GROUNDUP-GmbH/vibrocore/docs/design/ARCHITECTURE.md

# System Architecture

## Overview

The Vibrocore V1 consists of five major subsystems. Vibration is generated by
two industrial OLI motors (not custom eccentric shafts). Control runs on a
ruggedized WAGO PFC200 XTR with Modbus RTU to both the VFD and hub driver.

```
┌──────────────────────────────────────────────────────────────────────┐
│                          VIBROCORE V1                                │
├──────────────────────────────────────────────────────────────────────┤
│                                                                      │
│  ┌──────────────────┐  ┌──────────────┐  ┌────────────────────────┐ │
│  │  1. SONIC HEAD   │  │  2. HUB      │  │  3. CONTROL SYSTEM     │ │
│  │                  │  │     SYSTEM   │  │                        │ │
│  │  2× OLI MVE      │  │  Linear      │  │  WAGO PFC200 XTR       │ │
│  │  400/6-HF        │  │  push/pull   │  │  + Siemens V20 VFD     │ │
│  │  @100 Hz, 8 kN   │  │  via chain   │  │  + Nanotec C5-E driver │ │
│  └──────────────────┘  └──────────────┘  └────────────────────────┘ │
│                                                                      │
│  ┌──────────────────────────────────────────────────────────────┐   │
│  │                  4. POWER SYSTEM                              │   │
│  │  Instagrid ONE max (230V AC, 3.6 kW) → VFD + 48V PSU        │   │
│  └──────────────────────────────────────────────────────────────┘   │
│                                                                      │
│  ┌──────────────────────────────────────────────────────────────┐   │
│  │                  5. FRAME & MOBILITY                          │   │
│  │  mk 2004 Al-profile mast · steel base · UTV mount · tilt     │   │
│  └──────────────────────────────────────────────────────────────┘   │
│                                                                      │
└──────────────────────────────────────────────────────────────────────┘
```

---

## Subsystem Interactions

```
       ┌─────────────────────────────┐
       │  Tablet / HMI (WLAN)        │  viDoc RTK AR navigation
       │  + viDoc RTK Light          │  GPS sample point targeting
       └──────────────┬──────────────┘
                      │ WLAN (WAGO REST API / MQTT)
       ┌──────────────▼──────────────────────────────┐
       │           WAGO PFC200 XTR                   │
       │      (CODESYS V3.5 / IEC 61131-3)           │
       │                                             │
       │  PRG_Main → FB_Safety                       │
       │           → FB_SonicHead                    │
       │           → FB_HubControl                   │
       │           → FB_DataLogger                   │
       └──────┬──────────────────┬───────────────────┘
              │ RS-485             │ RS-485
              │ Modbus RTU         │ Modbus RTU
              │ Slave addr 1       │ Slave addr 2
       ┌──────▼──────┐     ┌──────▼──────┐
       │ Siemens V20 │     │ Nanotec C5-E│
       │  VFD 1.5kW  │     │ Stepper drv │
       │  OFF3 stop  │     │  CiA 402    │
       └──────┬──────┘     └──────┬──────┘
              │ 3×AC               │ Phase
              ▼                   ▼
       ┌─────────────┐     ┌─────────────────────┐
       │ 2× OLI MVE  │     │ NEMA 42 stepper      │
       │ 400/6-HF    │     │ + Neugart PLPE120-040│
       │ counter-rot.│     │ + 10B-2 chain        │
       │ 6000 RPM    │     │ + carriage slider    │
       │ 8 kN total  │     └──────────┬──────────┘
       └──────┬──────┘                │
              │ vibration             │ linear push/pull
       ┌──────▼──────┐                │
       │ Vibrating   │                │
       │ plate       ◄────────────────┘
       │ (S355J2)    │   carriage holds sonic head
       └──────┬──────┘
              │ rubber isolators (4× M12, 70 Shore A)
       ┌──────▼──────┐
       │ Center      │
       │ column      │
       │ (42CrMo4)   │
       └──────┬──────┘
              │ threaded adapter
       ┌──────▼──────────────┐
       │ DT325 Core Barrel   │
       │ 3.25″ × 48″ rod     │
       │ + cutting shoe      │
       └─────────────────────┘
```

---

## Critical Interlock: Sonic → Hub

The most important safety/quality interlock in the system:

```
DRILLING state:
  Hub moves DOWN  ←→  Sonic RUNNING
        │
        ▼ (target depth OR stone OR lower limit)
        │
STOP_SONIC state:
  Hub BRAKE engaged
  Sonic fast-stop (OFF3) requested
  ↓
  WAIT: xSonicConfirmedStopped = TRUE
  (OLI motors confirmed at standstill for 200ms)
        │
        ▼
RETRACT state:
  Hub moves UP  ←  Sonic CONFIRMED stopped
```

**Rule:** The hub carriage CANNOT transition to the RETRACT state without
`FB_SonicHead.xConfirmedStopped = TRUE`. This is structural in the state
machine — there is no path from DRILLING directly to RETRACT.

Reason: OLI motors at 6000 RPM shaking the soil core during extraction would
cause the sample to fall out, destroying the density measurement.

---

## Data / Trust Layer

```
Sampling cycle complete
        │
        ▼
FB_DataLogger (WAGO PFC200)
  → assembles JSON payload
  → includes GPS coords, depth, freq, current, cycle ID
  → sends over COM1 (UART 115200) to:
        │
        ▼
Xiao ESP32-C3 (RDDL Trust Wallet)
  → receives JSON from WAGO
  → reads GPS fix (u-blox ZED-F9P on drill head, NMEA → RTK)
  → calls NXP SE050 (I2C) for secp256k1 signing
  → appends {"signature":…, "pubkey":…}
        │
        ▼
RDDL / Planetmint (via MQTT over WiFi/LTE)
  → immutable data notarization
  → VM0042 Section 6.2 data provenance compliance
```

---

## Detailed Design Documents

- [SONIC_HEAD.md](SONIC_HEAD.md) — 2× OLI MVE 400/6-HF vibration head design
- [HUB_SYSTEM.md](HUB_SYSTEM.md) — NEMA 42, Neugart PLPE120-040, 10B-2 chain
- [CONTROL_SYSTEM.md](CONTROL_SYSTEM.md) — WAGO PFC200 XTR, I/O mapping, Modbus, SE050

## Firmware

- [firmware/codesys/PRG_Main.st](../../firmware/codesys/PRG_Main.st) — Main program
- [firmware/codesys/FB_SonicHead.st](../../firmware/codesys/FB_SonicHead.st) — Sonic state machine
- [firmware/codesys/FB_HubControl.st](../../firmware/codesys/FB_HubControl.st) — Hub state machine
- [firmware/codesys/FB_Safety.st](../../firmware/codesys/FB_Safety.st) — Safety monitor
- [firmware/codesys/FB_ModbusVFD.st](../../firmware/codesys/FB_ModbusVFD.st) — VFD Modbus
- [firmware/codesys/FB_DataLogger.st](../../firmware/codesys/FB_DataLogger.st) — RDDL data

## Engineering Calculations

- [DIMENSIONING.md](../engineering/DIMENSIONING.md) — Force, frequency, power, bearing life
- [BOM.md](../engineering/BOM.md) — Bill of materials with EU suppliers and prices
