GROUNDUP-GmbH/vibrocore/docs/references/REFERENCES.md

# References & Literature

## Primary Sources (Design Basis)

### Sonic Drilling Theory

1. **Šporin, J. & Vukelić, Ž.** (2017).
   *Structural drilling using the high-frequency (sonic) rotary method.*
   RMZ – M&G, Vol. 64, pp. 1–10.
   DOI: 10.1515/rmzmag-2017-0001
   - Rod resonance equation: f = c / 2l
   - Power equation: N = F²·t²·f / 2m
   - Sonic head kinematics (Resodyn Corp. diagram)
   - Forces: 22,000 – 127,000 kg in industrial systems
   - Frequencies: up to 150 Hz

2. **Wang, Y. et al.** (2015).
   *Design and model analysis of the sonic vibration head.*
   Journal of Vibroengineering, Vol. 17(5), pp. 2121–2131.
   https://www.extrica.com/article/15873
   - 3D FEM analysis of dual-eccentric vibration head
   - Lagrangian equations for damped forced vibration
   - Natural frequency analysis
   - Experimental validation

3. **Lucon, P.A.** (2013).
   *Resonance: The Science Behind the Art of Sonic Drilling.*
   Dissertation, Montana State University.
   - Comprehensive theory of resonance-enhanced drilling
   - Soil-rod interaction models

### Vibration Engineering

4. **OLI Vibrators** — Industrial Vibrators CIV Catalogue (2025/2026).
   https://www.olivibra.com/
   - VPI winding specifications
   - Heavy-duty bearing designs
   - MVE 300/3, MVE 400/3, MVE 1300/6N-HF specifications
   - Dual-unit synchronisation diagrams

### Core Sampling Equipment

5. **Geoprobe Systems** — DT325 Direct Push System.
   https://geoprobe.com/
   - 3.25" × 48" Probe Rod (PN: 201446) — 35.4 kg/pair
   - DT325 Cutting Shoe (PN: 205449)
   - 3.25" Drive Cap GH60 (PN: 201275)

## Related Open-Source Projects

6. **Open-Source Drilling Community** (GitHub)
   https://github.com/Open-Source-Drilling-Community
   - Drillstring models, drilling data analytics
   - Fokus: Öl/Gas-Tiefbohrung, nicht Soil Sampling

7. **ARTS Lab Smart Penetrometer** (GitHub)
   https://github.com/ARTS-Laboratory/Smart-Penetrometer-with-Edge-Computing-and-Intelligent-Embedded-Systems
   - UAV-deployable cone penetrometer
   - Edge computing for in-situ soil characterisation
   - Different approach (impact, not vibration)

8. **NASA USDC** — Ultrasonic/Sonic Driller/Corer
   https://ndeaa.jpl.nasa.gov/nasa-nde/usdc/usdc.htm
   - Piezoelectric ultrasonic actuation (> 20 kHz)
   - Planetary exploration focus
   - Different principle (ultrasonic vs. mechanical eccentric)

## Standards & Norms

9. **DIN 8187** — Roller chains, European standard (10B series)
10. **ISO 11783 (ISOBUS)** — Agricultural electronics communication
11. **IEC 60034** — Rotating electrical machines
12. **ISO 2372 / ISO 10816** — Mechanical vibration measurement
13. **EN ISO 13849** — Safety of machinery (for control system design)

## Component Datasheets (to be collected)

- [ ] Neugart PLPE120-040 datasheet
- [ ] SKF NJ 206 ECP bearing datasheet
- [ ] Gates HTD 8M belt design manual
- [ ] Nanotec ST11018 stepper motor datasheet
- [ ] CL86T-V4.1 driver manual
- [ ] Siemens V20 VFD quick start guide

---

*Note: PDF copies of academic papers are stored locally but not included in the
repository due to copyright. Reference by DOI or URL above.*
