GROUNDUP-GmbH/vibrocore/cad/export/pdf/VC-FR-4100_aluminium-profile-50x100x1500.pdf

VC-FR-4100 Aluminium profile 50x100x1500 Fidelity: envelope
Source: docs/engineering/BOM.md#3
Box 50 x 100 x 1500 mm
TODO: mk 2004 slot geometry is not in the repository. The solid is the outer envelope only and is not a machining model. TODO: Alloy and the exact mk order code.
Owner: Ground UP GmbH
Document status: preliminary
Identification: VC-FR-4100
Revision index/letter: 0 / A
Date: 2026-11-04
Units: mm. Projection: first angle (ISO 128).
General tolerances: TODO.
ISO 7200 title-block fields. Not released for manufacture.
