GROUNDUP-GmbH/vibrocore/cad/export/pdf/VC-FR-4300_bottom-steel-plate.pdf

VC-FR-4300 Bottom steel plate Fidelity: partial
Source: docs/engineering/BOM.md#3
Box 400 x 300 x 15 mm
TODO: Rod-guide bore position, NEMA 42 mount, profile feet and UTV holes. Owner: Ground UP GmbH
Document status: preliminary
Identification: VC-FR-4300
Revision index/letter: 0 / A
Date: 2026-11-04
Units: mm. Projection: first angle (ISO 128).
General tolerances: TODO.
ISO 7200 title-block fields. Not released for manufacture.
