GROUNDUP-GmbH/vibrocore/cad/export/pdf/VC-KIT-6000_dt325-sampling-kit.pdf

VC-KIT-6000 DT325 sampling kit assembly, preliminary 1 VC-GP-7100 rev A qty 2 DT325 probe rod pair
2 VC-GP-7200 rev A qty 4 DT325 cutting shoe
3 VC-GP-7300 rev A qty 1 Drive cap GH60
4 VC-GP-7400 rev A qty 50 Core liner 3.25 inch Owner: Ground UP GmbH
Document status: preliminary
Identification: VC-KIT-6000
Revision index/letter: 0 / A
Date: 2026-11-04
Units: mm. Projection: first angle (ISO 128).
General tolerances: TODO.
ISO 7200 title-block fields. Not released for manufacture.
