GROUNDUP-GmbH/vibrocore/cad/export/pdf/VC-KIT-7000_positioning-kit.pdf

VC-KIT-7000 Positioning kit assembly, preliminary 1 VC-PS-8100 rev A qty 1 viDoc RTK Light
2 VC-PS-8200 rev A qty 1 WLAN bridge Owner: Ground UP GmbH
Document status: preliminary Identification: VC-KIT-7000
Revision index/letter: 0 / A
Date: 2026-11-04
Units: mm. Projection: first angle (ISO 128).
General tolerances: TODO.
ISO 7200 title-block fields. Not released for manufacture.
