GROUNDUP-GmbH/vibrocore/cad/export/pdf/VC-SH-1100_oli-mve-400-6-hf.pdf

VC-SH-1100 OLI MVE 400/6-HF Fidelity: envelope
Source: docs/design/SONIC_HEAD.md#2.2
Box 255 x 154 x 175 mm
TODO: Which motor axis is the 90 mm bolt pitch, and which is the 125 mm pitch, is not stated. TODO: The solid is the published envelope, not a manufacturer model.
Owner: Ground UP GmbH
Document status: preliminary
Identification: VC-SH-1100
Revision index/letter: 0 / A
Date: 2026-11-04
Units: mm. Projection: first angle (ISO 128).
General tolerances: TODO.
ISO 7200 title-block fields. Not released for manufacture.
