GROUNDUP-GmbH/vibrocore/cad/odoo/plm/product.product.csv

id | name | default_code | type | is_storable | sale_ok | purchase_ok | uom_id/id | categ_id/id | standard_price | weight | description_purchase | engineering_code | engineering_revision | engineering_revision_letter | engineering_state | engineering_material | kit_bom | tmp_material/id
vibrocore.product_vc_asm_0000 | Vibrocore V1 | VC-ASM-0000 | consu | 1 | 1 | 0 | uom.product_uom_unit | vibrocore.categ_assemblies | 0.00 |  | Compact electric sonic vibro-corer for DT325 core tubes. Saleable machine, engineering revision 0. Legacy ref docs/engineering/BOM.md product. No own price. Use the rolled-up component estimates. TODO: Machine height is published as a range, 1.50-1.70 m, not a single value.; UTV mount and tilt-lock dimensions are not specified. Kits VC-KIT-6000 and VC-KIT-7000 are separate products, not lines of this manufacturing BOM. | VC-ASM-0000 | 0 | A | draft |  | 0
vibrocore.product_vc_asm_1000 | Sonic head assembly | VC-ASM-1000 | consu | 1 | 0 | 0 | uom.product_uom_unit | vibrocore.categ_assemblies | 0.00 |  | Counter-rotating pair of OLI MVE 400/6-HF motors on a rigid vibrating plate. Legacy ref docs/engineering/BOM.md 1. No own price. Use the rolled-up component estimates. TODO: Motor centre distance is only a minimum of 170 mm. It is not a frozen pitch, so the motors are not placed in the 3D model.; Isolator coordinates are not given. | VC-ASM-1000 | 0 | A | draft |  | 0
vibrocore.product_vc_asm_2000 | Hub system assembly | VC-ASM-2000 | consu | 1 | 0 | 0 | uom.product_uom_unit | vibrocore.categ_assemblies | 0.00 |  | NEMA 42, Neugart PLPE120-040 and 10B-2 chain lift for the sonic-head carriage. Legacy ref docs/engineering/BOM.md 2. No own price. Use the rolled-up component estimates. TODO: Carriage plate length and width are not given, only the 10 mm thickness.; Drive-shaft length is not given. Diameter is published as a range, 25-30 mm. | VC-ASM-2000 | 0 | A | draft |  | 0
vibrocore.product_vc_asm_3000 | Frame assembly | VC-ASM-3000 | consu | 1 | 0 | 0 | uom.product_uom_unit | vibrocore.categ_assemblies | 0.00 |  | mk 2004 mast, steel end plates, linear-guide side and UTV interface. Legacy ref docs/engineering/BOM.md 3. No own price. Use the rolled-up component estimates. TODO: Profile connector types are not identified beyond mk standard corners or T-slot nuts.; Tilt mechanism, gas strut and stabiliser feet have no selected order codes. | VC-ASM-3000 | 0 | A | draft |  | 0
vibrocore.product_vc_asm_4000 | Power system assembly | VC-ASM-4000 | consu | 1 | 0 | 0 | uom.product_uom_unit | vibrocore.categ_assemblies | 0.00 |  | Phase-1 power path from Instagrid ONE max to the VFD and the 48 V hub supply. Legacy ref docs/engineering/BOM.md 4. No own price. Use the rolled-up component estimates. | VC-ASM-4000 | 0 | A | draft |  | 0
vibrocore.product_vc_asm_5000 | Control system assembly | VC-ASM-5000 | consu | 1 | 0 | 0 | uom.product_uom_unit | vibrocore.categ_assemblies | 0.00 |  | WAGO PFC200 XTR rack, safety circuit, GPS head unit and Teltonika RUT241. Legacy ref docs/engineering/BOM.md 5. No own price. Use the rolled-up component estimates. | VC-ASM-5000 | 0 | A | draft |  | 0
vibrocore.product_vc_ct_6100 | WAGO PFC200 XTR | VC-CT-6100 | consu | 1 | 0 | 1 | uom.product_uom_unit | vibrocore.categ_control | 600.00 |  | Controller 750-8212, -40 to +70 C, 5 g vibration, two Ethernet ports, RS-485. Legacy ref docs/engineering/BOM.md 5.47. Preliminary unit estimate EUR 600.00–900.00. Not a supplier quote. Manufacturer PN: 750-8212. | VC-CT-6100 | 0 | A | draft |  | 0
vibrocore.product_vc_ct_6110 | WAGO 750-430 XTR | VC-CT-6110 | consu | 1 | 0 | 1 | uom.product_uom_unit | vibrocore.categ_control | 60.00 |  | 4 digital inputs, 24 V DC, CAGE CLAMP. Legacy ref docs/engineering/BOM.md 5.48. Preliminary unit estimate EUR 60.00–90.00. Not a supplier quote. Manufacturer PN: 750-430. | VC-CT-6110 | 0 | A | draft |  | 0
vibrocore.product_vc_ct_6120 | WAGO 750-530 XTR | VC-CT-6120 | consu | 1 | 0 | 1 | uom.product_uom_unit | vibrocore.categ_control | 60.00 |  | 4 digital outputs, 24 V DC, 0.5 A, CAGE CLAMP. Legacy ref docs/engineering/BOM.md 5.49. Preliminary unit estimate EUR 60.00–90.00. Not a supplier quote. Manufacturer PN: 750-530. | VC-CT-6120 | 0 | A | draft |  | 0
vibrocore.product_vc_ct_6130 | WAGO 750-637 | VC-CT-6130 | consu | 1 | 0 | 1 | uom.product_uom_unit | vibrocore.categ_control | 100.00 |  | Incremental encoder interface. Legacy ref docs/engineering/BOM.md 5.50. Preliminary unit estimate EUR 100.00–150.00. Not a supplier quote. Manufacturer PN: 750-637. | VC-CT-6130 | 0 | A | draft |  | 0
vibrocore.product_vc_ct_6140 | WAGO 750-826 | VC-CT-6140 | consu | 1 | 0 | 1 | uom.product_uom_unit | vibrocore.categ_control | 80.00 |  | RS-485 serial interface for Modbus RTU. Legacy ref docs/engineering/BOM.md 5.51. Preliminary unit estimate EUR 80.00–120.00. Not a supplier quote. Manufacturer PN: 750-826. | VC-CT-6140 | 0 | A | draft |  | 0
vibrocore.product_vc_ct_6150 | WAGO 750-600 | VC-CT-6150 | consu | 1 | 0 | 1 | uom.product_uom_unit | vibrocore.categ_control | 10.00 |  | End module. Legacy ref docs/engineering/BOM.md 5.52. Preliminary unit estimate EUR 10.00–20.00. Not a supplier quote. Manufacturer PN: 750-600. | VC-CT-6150 | 0 | A | draft |  | 0
vibrocore.product_vc_ct_6200 | Inductive limit switch | VC-CT-6200 | consu | 1 | 0 | 1 | uom.product_uom_unit | vibrocore.categ_control | 15.00 |  | M12 inductive limit switch, NC, IP67. Upper and lower carriage. Legacy ref docs/engineering/BOM.md 5.53. Preliminary unit estimate EUR 15.00–30.00. Not a supplier quote. ifm or SICK. | VC-CT-6200 | 0 | A | draft |  | 0
vibrocore.product_vc_ct_6210 | Emergency stop | VC-CT-6210 | consu | 1 | 0 | 1 | uom.product_uom_unit | vibrocore.categ_control | 40.00 |  | Mushroom NC, Category 3, in an IP65 enclosure. Legacy ref docs/engineering/BOM.md 5.54. Preliminary unit estimate EUR 40.00–70.00. Not a supplier quote. Eaton or Schneider. | VC-CT-6210 | 0 | A | draft |  | 0
vibrocore.product_vc_ct_6220 | Safety relay | VC-CT-6220 | consu | 1 | 0 | 1 | uom.product_uom_unit | vibrocore.categ_control | 80.00 |  | Pilz PNOZ m B0 or equivalent. Legacy ref docs/engineering/BOM.md 5.55. Preliminary unit estimate EUR 80.00–130.00. Not a supplier quote. PNOZ m B0 is a candidate, not a frozen order. | VC-CT-6220 | 0 | A | draft |  | 0
vibrocore.product_vc_ct_6300 | Control enclosure | VC-CT-6300 | consu | 1 | 0 | 1 | uom.product_uom_unit | vibrocore.categ_control | 40.00 |  | IP65 enclosure with DIN rail, 200 x 150 x 80 mm. Legacy ref docs/engineering/BOM.md 5.56. Preliminary unit estimate EUR 40.00–80.00. Not a supplier quote. TODO: Confirm the enclosure actually fits the WAGO rack and the VFD. Do not treat 200 x 150 x 80 mm as a checked layout. Rittal or Spelsberg. The 200 x 150 x 80 mm size is unlikely to hold the PFC200 rack, the VFD and the driver together. | VC-CT-6300 | 0 | A | draft |  | 0
vibrocore.product_vc_ct_6400 | RDDL trust wallet | VC-CT-6400 | consu | 1 | 0 | 1 | uom.product_uom_unit | vibrocore.categ_control | 25.00 |  | Xiao ESP32-C3 with an NXP SE050 breakout for the signing path. Legacy ref docs/engineering/BOM.md 5.57. Preliminary unit estimate EUR 25.00–50.00. Not a supplier quote. Seeed Studio or Mouser. | VC-CT-6400 | 0 | A | draft |  | 0
vibrocore.product_vc_ct_6410 | SE050 breakout | VC-CT-6410 | consu | 1 | 0 | 1 | uom.product_uom_unit | vibrocore.categ_control | 20.00 |  | NXP OM-SE050ARD or a compatible SE050 breakout. Legacy ref docs/engineering/BOM.md 5.58. Preliminary unit estimate EUR 20.00–40.00. Not a supplier quote. Manufacturer PN: OM-SE050ARD. Listed both inside the wallet line and as its own board. Confirm this is not a double purchase. | VC-CT-6410 | 0 | A | draft |  | 0
vibrocore.product_vc_ct_6500 | GPS antenna u-blox ANN-MB | VC-CT-6500 | consu | 1 | 0 | 1 | uom.product_uom_unit | vibrocore.categ_control | 50.00 |  | Multi-band GNSS antenna, SMA, mounted on the drill head. Legacy ref docs/engineering/BOM.md 5.59. Preliminary unit estimate EUR 50.00–80.00. Not a supplier quote. Manufacturer PN: ANN-MB. Same function as BOM.md section 7 item 61. Not duplicated on the positioning kit. | VC-CT-6500 | 0 | A | draft |  | 0
vibrocore.product_vc_ct_6510 | GPS receiver u-blox ZED-F9P | VC-CT-6510 | consu | 1 | 0 | 1 | uom.product_uom_unit | vibrocore.categ_control | 150.00 |  | RTK-capable GNSS receiver for the drill-head antenna. Legacy ref docs/engineering/BOM.md 5.60. Preliminary unit estimate EUR 150.00–250.00. Not a supplier quote. Manufacturer PN: ZED-F9P. Same function as BOM.md section 7 item 62. Not duplicated on the positioning kit. | VC-CT-6510 | 0 | A | draft |  | 0
vibrocore.product_vc_ct_6600 | Teltonika RUT241 | VC-CT-6600 | consu | 1 | 0 | 1 | uom.product_uom_unit | vibrocore.categ_control | 100.00 |  | LTE Cat 4 router, DIN rail, -40 to +75 C. Legacy ref docs/engineering/BOM.md 5.61. Preliminary unit estimate EUR 100.00–160.00. Not a supplier quote. Manufacturer PN: RUT241. | VC-CT-6600 | 0 | A | draft |  | 0
vibrocore.product_vc_ct_6610 | LTE SIM data plan | VC-CT-6610 | service | 0 | 0 | 1 | uom.product_uom_unit | vibrocore.categ_control | 10.00 |  | Data-only SIM, about 1 GB per month, AT or HU carrier. Legacy ref docs/engineering/BOM.md 5.62. Preliminary unit estimate EUR 10.00–20.00. Not a supplier quote. Service product, not stock. | VC-CT-6610 | 0 | A | draft |  | 0
vibrocore.product_vc_ct_6620 | DC converter 24 V to 9 V | VC-CT-6620 | consu | 1 | 0 | 1 | uom.product_uom_unit | vibrocore.categ_control | 10.00 |  | Step-down for the RUT241 from the 24 V rail. RUT241 accepts 9-30 V, so this may be unnecessary. Legacy ref docs/engineering/BOM.md 5.63. Preliminary unit estimate EUR 10.00–20.00. Not a supplier quote. TODO: Confirm the router is not powered directly from 24 V. | VC-CT-6620 | 0 | A | draft |  | 0
vibrocore.product_vc_ct_6700 | Wiring harness | VC-CT-6700 | consu | 1 | 0 | 1 | uom.product_uom_unit | vibrocore.categ_control | 50.00 |  | CAGE CLAMP terminals and shielded signal cables. Legacy ref docs/engineering/BOM.md 5.64. Preliminary unit estimate EUR 50.00–90.00. Not a supplier quote. Weidmueller or Phoenix Contact. | VC-CT-6700 | 0 | A | draft |  | 0
vibrocore.product_vc_fr_4100 | Aluminium profile 50x100x1500 | VC-FR-4100 | consu | 1 | 0 | 1 | uom.product_uom_unit | vibrocore.categ_frame | 60.00 |  | mk 2004 profile, 50 x 100 mm, length 1500 mm. Two profiles. Legacy ref docs/engineering/BOM.md 3.32. Preliminary unit estimate EUR 60.00–90.00. Not a supplier quote. TODO: mk 2004 slot geometry is not in the repository. The solid is the outer envelope only and is not a machining model.; Alloy and the exact mk order code. | VC-FR-4100 | 0 | A | draft |  | 0
vibrocore.product_vc_fr_4200 | Profile connector | VC-FR-4200 | consu | 1 | 0 | 1 | uom.product_uom_unit | vibrocore.categ_frame | 5.00 |  | mk standard corner or T-slot connector. Eight pieces. Legacy ref docs/engineering/BOM.md 3.33. Preliminary unit estimate EUR 5.00–10.00. Not a supplier quote. TODO: Which mk connector. | VC-FR-4200 | 0 | A | draft |  | 0
vibrocore.product_vc_fr_4300 | Bottom steel plate | VC-FR-4300 | consu | 1 | 0 | 1 | uom.product_uom_unit | vibrocore.categ_frame | 80.00 | 14.130 | S355 blank 400 x 300 x 15 mm. Rod guide, motor mount and profile seats are not yet located. Legacy ref docs/engineering/BOM.md 3.34. Preliminary unit estimate EUR 80.00–120.00. Not a supplier quote. Material: S355. TODO: Rod-guide bore position, NEMA 42 mount, profile feet and UTV holes. | VC-FR-4300 | 0 | A | draft | S355 | 0 | vibrocore.material_s355
vibrocore.product_vc_fr_4400 | Top steel plate | VC-FR-4400 | consu | 1 | 0 | 1 | uom.product_uom_unit | vibrocore.categ_frame | 50.00 | 5.652 | S355 blank 300 x 200 x 12 mm. Legacy ref docs/engineering/BOM.md 3.35. Preliminary unit estimate EUR 50.00–80.00. Not a supplier quote. Material: S355. TODO: Idle-sprocket mount and profile bolt pattern. | VC-FR-4400 | 0 | A | draft | S355 | 0 | vibrocore.material_s355
vibrocore.product_vc_fr_4500 | Rod guide bushing | VC-FR-4500 | consu | 1 | 0 | 1 | uom.product_uom_unit | vibrocore.categ_frame | 20.00 |  | Bronze or PTFE bushing, 83 mm bore, for the 82.55 mm DT325 rod. Legacy ref docs/engineering/BOM.md 3.36. Preliminary unit estimate EUR 20.00–40.00. Not a supplier quote. TODO: Length, flange and housing diameter. | VC-FR-4500 | 0 | A | draft |  | 0
vibrocore.product_vc_fr_4600 | UTV mounting bracket | VC-FR-4600 | consu | 1 | 0 | 1 | uom.product_uom_unit | vibrocore.categ_frame | 15.00 |  | Steel bracket, welded or bolted. Four pieces. Legacy ref docs/engineering/BOM.md 3.37. Preliminary unit estimate EUR 15.00–25.00. Not a supplier quote. TODO: UTV interface dimensions. | VC-FR-4600 | 0 | A | draft |  | 0
vibrocore.product_vc_fr_4700 | Tilt mechanism | VC-FR-4700 | consu | 1 | 0 | 1 | uom.product_uom_unit | vibrocore.categ_frame | 100.00 |  | Hinge, gas strut and lock for transport. Legacy ref docs/engineering/BOM.md 3.38. Preliminary unit estimate EUR 100.00–180.00. Not a supplier quote. TODO: Strut force, hinge pin and lock. | VC-FR-4700 | 0 | A | draft |  | 0
vibrocore.product_vc_fr_4800 | Stabiliser foot | VC-FR-4800 | consu | 1 | 0 | 1 | uom.product_uom_unit | vibrocore.categ_frame | 10.00 |  | Adjustable screw jack. Four feet. Legacy ref docs/engineering/BOM.md 3.39. Preliminary unit estimate EUR 10.00–20.00. Not a supplier quote. TODO: Selected jack and the pad size. | VC-FR-4800 | 0 | A | draft |  | 0
vibrocore.product_vc_fr_4900 | Fastener kit, frame | VC-FR-4900 | consu | 1 | 0 | 1 | uom.product_uom_unit | vibrocore.categ_frame | 30.00 |  | M8 to M16 fasteners for the frame, one kit. Legacy ref docs/engineering/BOM.md 3.40. Preliminary unit estimate EUR 30.00–50.00. Not a supplier quote. | VC-FR-4900 | 0 | A | draft |  | 0
vibrocore.product_vc_gp_7100 | DT325 probe rod pair | VC-GP-7100 | consu | 1 | 0 | 1 | uom.product_uom_unit | vibrocore.categ_sampling | 400.00 | 35.400 | Geoprobe probe rod 3.25 inch by 48 inch. The unit of purchase is a pair, 35.4 kg. Legacy ref docs/engineering/BOM.md 6.56. Preliminary unit estimate EUR 400.00–600.00. Not a supplier quote. Manufacturer PN: 201446. | VC-GP-7100 | 0 | A | draft |  | 0
vibrocore.product_vc_gp_7200 | DT325 cutting shoe | VC-GP-7200 | consu | 1 | 0 | 1 | uom.product_uom_unit | vibrocore.categ_sampling | 50.00 | 1.500 | DT325 cutting shoe. Legacy ref docs/engineering/BOM.md 6.57. Preliminary unit estimate EUR 50.00–100.00. Not a supplier quote. Manufacturer PN: 205449. | VC-GP-7200 | 0 | A | draft |  | 0
vibrocore.product_vc_gp_7300 | Drive cap GH60 | VC-GP-7300 | consu | 1 | 0 | 1 | uom.product_uom_unit | vibrocore.categ_sampling | 100.00 |  | Geoprobe GH60 drive cap. Legacy ref docs/engineering/BOM.md 6.58. Preliminary unit estimate EUR 100.00–200.00. Not a supplier quote. Manufacturer PN: 201275. | VC-GP-7300 | 0 | A | draft |  | 0
vibrocore.product_vc_gp_7400 | Core liner 3.25 inch | VC-GP-7400 | consu | 1 | 0 | 1 | uom.product_uom_unit | vibrocore.categ_sampling | 3.00 |  | Polycarbonate liner, 3.25 inch. Consumable. Legacy ref docs/engineering/BOM.md 6.59. Preliminary unit estimate EUR 3.00–6.00. Not a supplier quote. | VC-GP-7400 | 0 | A | draft |  | 0
vibrocore.product_vc_hb_2100 | NEMA 42 closed-loop stepper | VC-HB-2100 | consu | 1 | 0 | 1 | uom.product_uom_unit | vibrocore.categ_hub | 250.00 |  | NEMA 42, closed loop, about 20 Nm, 6 A, incremental encoder, 19 mm keyed shaft. Legacy ref docs/engineering/BOM.md 2.17. Preliminary unit estimate EUR 250.00–400.00. Not a supplier quote. TODO: Exact catalogue number, body length and mass. Candidates: Nanotec, Leadshine. Mass is published as about 6-8 kg, so no single mass is stored. | VC-HB-2100 | 0 | A | draft |  | 0
vibrocore.product_vc_hb_2200 | Planetary gearbox PLPE120-040 | VC-HB-2200 | consu | 1 | 0 | 1 | uom.product_uom_unit | vibrocore.categ_hub | 600.00 |  | Neugart PLPE120, ratio 40:1, output shaft 32 mm with keyway. Legacy ref docs/engineering/BOM.md 2.18. Preliminary unit estimate EUR 600.00–900.00. Not a supplier quote. Manufacturer PN: PLPE120-040. TODO: Input flange code for the selected NEMA 42 motor. | VC-HB-2200 | 0 | A | draft |  | 0
vibrocore.product_vc_hb_2300 | Closed-loop stepper driver | VC-HB-2300 | consu | 1 | 0 | 1 | uom.product_uom_unit | vibrocore.categ_hub | 80.00 |  | Leadshine CL86T-V4.1 or Nanotec C5-E. Modbus / CiA 402 to the PFC200. Legacy ref docs/engineering/BOM.md 2.19. Preliminary unit estimate EUR 80.00–150.00. Not a supplier quote. TODO: Final driver, and therefore the connector and the encoder interface. CONTROL_SYSTEM.md draws the Nanotec C5-E. BOM.md leaves both candidates. Installed in the control enclosure. | VC-HB-2300 | 0 | A | draft |  | 0
vibrocore.product_vc_hb_2400 | Elastomer coupling | VC-HB-2400 | consu | 1 | 0 | 1 | uom.product_uom_unit | vibrocore.categ_hub | 60.00 |  | R+W EKH or KTR ROTEX 28, torque only, between gearbox and drive shaft. Legacy ref docs/engineering/BOM.md 2.20. Preliminary unit estimate EUR 60.00–100.00. Not a supplier quote. TODO: Bore pair. Gearbox output is 32 mm; the drive shaft is not frozen. | VC-HB-2400 | 0 | A | draft |  | 0
vibrocore.product_vc_hb_2500 | Hub drive shaft | VC-HB-2500 | consu | 1 | 0 | 1 | uom.product_uom_unit | vibrocore.categ_hub | 30.00 |  | Keyed shaft, diameter 25-30 mm, separately bearing-mounted. Legacy ref docs/engineering/BOM.md 2.21. Preliminary unit estimate EUR 30.00–50.00. Not a supplier quote. TODO: Diameter inside the 25-30 mm range, length, key size and sprocket seat. | VC-HB-2500 | 0 | A | draft |  | 0
vibrocore.product_vc_hb_2600 | Pillow block UCP 206 | VC-HB-2600 | consu | 1 | 0 | 1 | uom.product_uom_unit | vibrocore.categ_hub | 15.00 |  | Self-aligning pillow block, 30 mm bore. Two on the drive shaft. Legacy ref docs/engineering/BOM.md 2.22. Preliminary unit estimate EUR 15.00–25.00. Not a supplier quote. TODO: Confirm 30 mm bore against the final shaft diameter. HUB_SYSTEM.md also mentions UCP 205/206. SKF or Schaeffler. Bore is 30 mm, which only matches the top of the shaft range. | VC-HB-2600 | 0 | A | draft |  | 0
vibrocore.product_vc_hb_2700 | Duplex chain 10B-2 | VC-HB-2700 | consu | 1 | 0 | 1 | uom.product_uom_unit | vibrocore.categ_hub | 30.00 |  | 10B-2 duplex roller chain, 3.2 m, pre-greased. Pitch 15.875 mm. Legacy ref docs/engineering/BOM.md 2.23. Preliminary unit estimate EUR 30.00–50.00. Not a supplier quote. iwis or Wippermann. | VC-HB-2700 | 0 | A | draft |  | 0
vibrocore.product_vc_hb_2800 | Sprocket 10B-2 15T drive | VC-HB-2800 | consu | 1 | 0 | 1 | uom.product_uom_unit | vibrocore.categ_hub | 25.00 |  | 10B-2, 15 teeth, taper-lock, drive sprocket. Legacy ref docs/engineering/BOM.md 2.24. Preliminary unit estimate EUR 25.00–40.00. Not a supplier quote. z24.de or ETKF. Pitch radius used in the force calculation is 37.9 mm. | VC-HB-2800 | 0 | A | draft |  | 0
vibrocore.product_vc_hb_2810 | Sprocket 10B-2 15T idle | VC-HB-2810 | consu | 1 | 0 | 1 | uom.product_uom_unit | vibrocore.categ_hub | 30.00 |  | 10B-2, 15 teeth, bearing-mounted idle sprocket. Legacy ref docs/engineering/BOM.md 2.25. Preliminary unit estimate EUR 30.00–50.00. Not a supplier quote. | VC-HB-2810 | 0 | A | draft |  | 0
vibrocore.product_vc_hb_2900 | Chain tensioner | VC-HB-2900 | consu | 1 | 0 | 1 | uom.product_uom_unit | vibrocore.categ_hub | 20.00 |  | Spring or adjustable tensioner for the 10B-2 loop. Legacy ref docs/engineering/BOM.md 2.26. Preliminary unit estimate EUR 20.00–40.00. Not a supplier quote. TODO: Selected model. | VC-HB-2900 | 0 | A | draft |  | 0
vibrocore.product_vc_hb_3000 | Power-off brake 24 V | VC-HB-3000 | consu | 1 | 0 | 1 | uom.product_uom_unit | vibrocore.categ_hub | 100.00 |  | Spring-applied electromagnetic brake, 24 V, holding torque above 15 Nm, between motor and gearbox. Legacy ref docs/engineering/BOM.md 2.27. Preliminary unit estimate EUR 100.00–180.00. Not a supplier quote. TODO: Catalogue number and the matching shaft bore. Kendrion or Mayr. | VC-HB-3000 | 0 | A | draft |  | 0
vibrocore.product_vc_hb_3100 | Linear guide rail HGR20 | VC-HB-3100 | consu | 1 | 0 | 1 | uom.product_uom_unit | vibrocore.categ_hub | 50.00 |  | Profiled rail, size 20, length 1300 mm. Two rails. Legacy ref docs/engineering/BOM.md 2.28. Preliminary unit estimate EUR 50.00–90.00. Not a supplier quote. Hiwin or Bosch Rexroth. HGR20 is the Hiwin designation used in BOM.md. | VC-HB-3100 | 0 | A | draft |  | 0
vibrocore.product_vc_hb_3110 | Linear carriage HGH20 | VC-HB-3110 | consu | 1 | 0 | 1 | uom.product_uom_unit | vibrocore.categ_hub | 20.00 |  | Ball-type carriage for the size-20 rail. Four carriages. Legacy ref docs/engineering/BOM.md 2.29. Preliminary unit estimate EUR 20.00–35.00. Not a supplier quote. | VC-HB-3110 | 0 | A | draft |  | 0
vibrocore.product_vc_hb_3200 | Carriage plate | VC-HB-3200 | consu | 1 | 0 | 1 | uom.product_uom_unit | vibrocore.categ_hub | 80.00 |  | Machined steel plate, 10 mm thick, four carriages, chain pin, four M12 isolators. Legacy ref docs/engineering/BOM.md 2.30. Preliminary unit estimate EUR 80.00–120.00. Not a supplier quote. TODO: Length, width, hole pattern and chain-pin position. Thickness alone is not enough to model a blank. | VC-HB-3200 | 0 | A | draft |  | 0
vibrocore.product_vc_hb_3300 | Fastener kit, hub | VC-HB-3300 | consu | 1 | 0 | 1 | uom.product_uom_unit | vibrocore.categ_hub | 20.00 |  | M6 to M12 fasteners for the hub assembly, one kit. Legacy ref docs/engineering/BOM.md 2.31. Preliminary unit estimate EUR 20.00–40.00. Not a supplier quote. | VC-HB-3300 | 0 | A | draft |  | 0
vibrocore.product_vc_kit_6000 | DT325 sampling kit | VC-KIT-6000 | consu | 1 | 1 | 0 | uom.product_uom_unit | vibrocore.categ_sampling | 0.00 |  | Geoprobe DT325 rods, cutting shoes, drive cap and liners. Field kit, not part of the machine BOM. Legacy ref docs/engineering/BOM.md 6. No own price. Use the rolled-up component estimates. | VC-KIT-6000 | 0 | A | draft |  | 1
vibrocore.product_vc_kit_7000 | Positioning kit | VC-KIT-7000 | consu | 1 | 1 | 0 | uom.product_uom_unit | vibrocore.categ_positioning | 0.00 |  | viDoc RTK Light and the WLAN bridge. The drill-head GPS is on the control assembly. Legacy ref docs/engineering/BOM.md 7. No own price. Use the rolled-up component estimates. BOM.md section 7 also lists a second GPS antenna and receiver. Those rows duplicate section 5 and are not repeated here. | VC-KIT-7000 | 0 | A | draft |  | 1
vibrocore.product_vc_ps_8100 | viDoc RTK Light | VC-PS-8100 | consu | 1 | 0 | 1 | uom.product_uom_unit | vibrocore.categ_positioning | 2000.00 |  | RTK rover with AR navigation. May already be owned. Legacy ref docs/engineering/BOM.md 7.60. Preliminary unit estimate EUR 2000.00–2000.00. Not a supplier quote. BOM.md marks this as an existing instrument in the realistic budget. | VC-PS-8100 | 0 | A | draft |  | 0
vibrocore.product_vc_ps_8200 | WLAN bridge | VC-PS-8200 | consu | 1 | 0 | 1 | uom.product_uom_unit | vibrocore.categ_positioning | 20.00 |  | Bridge from the head GPS path to the tablet. BOM.md names an ESP32 module. Legacy ref docs/engineering/BOM.md 7.63. Preliminary unit estimate EUR 20.00–40.00. Not a supplier quote. Possibly the same radio as the ESP32-C3 wallet. Not merged until someone checks the architecture. | VC-PS-8200 | 0 | A | draft |  | 0
vibrocore.product_vc_pw_5100 | Instagrid ONE max | VC-PW-5100 | consu | 1 | 0 | 1 | uom.product_uom_unit | vibrocore.categ_power | 2500.00 |  | Portable battery inverter, 230 V AC, 3.6 kW continuous, 2.1 kWh. Legacy ref docs/engineering/BOM.md 4.41. Preliminary unit estimate EUR 2500.00–2500.00. Not a supplier quote. BOM.md also allows rental at about EUR 95 per week. That rental is not this product. | VC-PW-5100 | 0 | A | draft |  | 0
vibrocore.product_vc_pw_5200 | DIN-rail supply 48 V 10 A | VC-PW-5200 | consu | 1 | 0 | 1 | uom.product_uom_unit | vibrocore.categ_power | 80.00 |  | 230 V AC to 48 V DC, 10 A, DIN rail, for the hub drive. Legacy ref docs/engineering/BOM.md 4.42. Preliminary unit estimate EUR 80.00–140.00. Not a supplier quote. CONTROL_SYSTEM.md shows Mean Well SDR-75-48, which is 1.6 A, not 10 A. Do not order SDR-75-48 against this line until the conflict is closed. | VC-PW-5200 | 0 | A | draft |  | 0
vibrocore.product_vc_pw_5300 | DC converter 48 V to 24 V | VC-PW-5300 | consu | 1 | 0 | 1 | uom.product_uom_unit | vibrocore.categ_power | 20.00 |  | 48 V to 24 V for the brake and the relays. Legacy ref docs/engineering/BOM.md 4.43. Preliminary unit estimate EUR 20.00–40.00. Not a supplier quote. CONTROL_SYSTEM.md names Mean Well DDR-60D-24 (24 V / 2.5 A) as a candidate only. | VC-PW-5300 | 0 | A | draft |  | 0
vibrocore.product_vc_pw_5400 | DC converter 48 V to 12 V and 5 V | VC-PW-5400 | consu | 1 | 0 | 1 | uom.product_uom_unit | vibrocore.categ_power | 15.00 |  | Logic supply for the PLC side and sensors. BOM.md groups 12 V and 5 V on one line. Legacy ref docs/engineering/BOM.md 4.44. Preliminary unit estimate EUR 15.00–30.00. Not a supplier quote. TODO: Whether this is one dual-output converter or two parts. | VC-PW-5400 | 0 | A | draft |  | 0
vibrocore.product_vc_pw_5500 | Power distribution kit | VC-PW-5500 | consu | 1 | 0 | 1 | uom.product_uom_unit | vibrocore.categ_power | 60.00 |  | DIN-rail distribution, fuses and contactors. Legacy ref docs/engineering/BOM.md 4.45. Preliminary unit estimate EUR 60.00–100.00. Not a supplier quote. Schneider or Eaton. Not exploded. | VC-PW-5500 | 0 | A | draft |  | 0
vibrocore.product_vc_pw_5600 | Power cable set | VC-PW-5600 | consu | 1 | 0 | 1 | uom.product_uom_unit | vibrocore.categ_power | 40.00 |  | Silicone and shielded power cables, 2.5-6 mm2. Legacy ref docs/engineering/BOM.md 4.46. Preliminary unit estimate EUR 40.00–80.00. Not a supplier quote. | VC-PW-5600 | 0 | A | draft |  | 0
vibrocore.product_vc_sh_1100 | OLI MVE 400/6-HF | VC-SH-1100 | consu | 1 | 0 | 1 | uom.product_uom_unit | vibrocore.categ_sonic_head | 300.00 | 7.200 | High-frequency vibration motor, 408 kgf, 7.2 kg, 255 x 154 x 175 mm, bolt pattern 90 x 125 mm, 4x M12. Legacy ref docs/engineering/BOM.md 1.1. Preliminary unit estimate EUR 300.00–450.00. Not a supplier quote. Manufacturer PN: MVE 400/6-HF. TODO: Which motor axis is the 90 mm bolt pitch, and which is the 125 mm pitch, is not stated.; The solid is the published envelope, not a manufacturer model. | VC-SH-1100 | 0 | A | draft |  | 0
vibrocore.product_vc_sh_1200 | Frequency inverter 1.5 kW | VC-SH-1200 | consu | 1 | 0 | 1 | uom.product_uom_unit | vibrocore.categ_sonic_head | 180.00 |  | 1.5 kW, 230 V single-phase in, three-phase out, V/f, output to 400 Hz. Legacy ref docs/engineering/BOM.md 1.2. Preliminary unit estimate EUR 180.00–300.00. Not a supplier quote. TODO: Enclosure size, braking behaviour beyond the V20 parameter notes, and the final order code. Candidates named in the docs: Siemens SINAMICS V20, ABB ACS150. No order code is selected. Mounted in the control enclosure, kept on the sonic-head BOM because BOM.md lists it there. | VC-SH-1200 | 0 | A | draft |  | 0
vibrocore.product_vc_sh_1300 | Vibrating plate weldment | VC-SH-1300 | consu | 1 | 0 | 0 | uom.product_uom_unit | vibrocore.categ_sonic_head | 200.00 |  | S355J2 plate 420 x 300 x 20 mm with two longitudinal ribs 300 x 60 x 10 mm. Legacy ref docs/engineering/BOM.md 1.3. Preliminary unit estimate EUR 200.00–350.00. Not a supplier quote. Material: S355J2. TODO: Rib spacing and weld details are not specified, so the ribs are separate blanks and are not positioned on the plate. | VC-SH-1300 | 0 | A | draft | S355J2 | 0 | vibrocore.material_s355j2
vibrocore.product_vc_sh_1301 | Vibrating plate blank | VC-SH-1301 | consu | 1 | 0 | 1 | uom.product_uom_unit | vibrocore.categ_sonic_head | 0.00 | 19.782 | S355J2 blank 420 x 300 x 20 mm. Motor holes and isolator holes are not in this blank. Legacy ref docs/engineering/BOM.md 1.3a. No own price. Cost is included in VC-SH-1300. Material: S355J2. TODO: 4x M12 isolator coordinates.; Two times 4x M12 motor holes. Pitch is 90 x 125 mm, location on the plate is not fixed.; Edge preparation, surface finish and whether the plate is 20 mm finished or stock. | VC-SH-1301 | 0 | A | draft | S355J2 | 0 | vibrocore.material_s355j2
vibrocore.product_vc_sh_1302 | Stiffener rib | VC-SH-1302 | consu | 1 | 0 | 1 | uom.product_uom_unit | vibrocore.categ_sonic_head | 0.00 | 1.413 | Longitudinal rib blank 300 x 60 x 10 mm, two per plate. Legacy ref docs/engineering/BOM.md 1.3b. No own price. Cost is included in VC-SH-1300. Material: S355J2. TODO: Weld position on the plate. | VC-SH-1302 | 0 | A | draft | S355J2 | 0 | vibrocore.material_s355j2
vibrocore.product_vc_sh_1400 | Center column | VC-SH-1400 | consu | 1 | 0 | 1 | uom.product_uom_unit | vibrocore.categ_sonic_head | 80.00 | 3.500 | 42CrMo4 shaft, diameter 50 mm, length 200 mm, plus a flange that is not fully dimensioned. Legacy ref docs/engineering/BOM.md 1.4. Preliminary unit estimate EUR 80.00–120.00. Not a supplier quote. Material: 42CrMo4. TODO: Flange thickness, bolt-circle diameter and whether the 6x M10 holes are tapped or through.; Flange diameter 80 mm is published, but it is not modelled until the thickness is known. | VC-SH-1400 | 0 | A | draft | 42CrMo4 | 0 | vibrocore.material_cr42mo4
vibrocore.product_vc_sh_1500 | DT325 adapter | VC-SH-1500 | consu | 1 | 0 | 1 | uom.product_uom_unit | vibrocore.categ_sonic_head | 60.00 |  | Steel adapter, thread to the Geoprobe DT325 drive interface. Legacy ref docs/engineering/BOM.md 1.5. Preliminary unit estimate EUR 60.00–100.00. Not a supplier quote. TODO: Thread designation, engagement length and wrench flats. Do not model until the Geoprobe interface is confirmed. | VC-SH-1500 | 0 | A | draft |  | 0
vibrocore.product_vc_sh_1600 | Rubber isolator M12 | VC-SH-1600 | consu | 1 | 0 | 1 | uom.product_uom_unit | vibrocore.categ_sonic_head | 7.50 |  | Cylindrical rubber buffer, M12, 55-70 Shore A, static stiffness about 40-50 kN/m. Legacy ref docs/engineering/BOM.md 1.6. Preliminary unit estimate EUR 7.50–15.00. Not a supplier quote. TODO: Catalogue number, free height and stud length. Candidates: Schwingmetall, Paulstra, Trelleborg. No catalogue number selected. | VC-SH-1600 | 0 | A | draft |  | 0
vibrocore.product_vc_sh_1700 | Motor cable shielded | VC-SH-1700 | consu | 1 | 0 | 1 | uom.product_uom_unit | vibrocore.categ_sonic_head | 7.50 |  | Shielded motor cable 3x 1.5 mm2, length under 5 m, one per motor. Legacy ref docs/engineering/BOM.md 1.7. Preliminary unit estimate EUR 7.50–15.00. Not a supplier quote. TODO: Exact length and gland sizes. | VC-SH-1700 | 0 | A | draft |  | 0
vibrocore.product_vc_sh_1800 | Fastener kit, sonic head | VC-SH-1800 | consu | 1 | 0 | 1 | uom.product_uom_unit | vibrocore.categ_sonic_head | 20.00 |  | M12x40 for the motors and M10 for the column flange, plus washers. Purchased as one kit. Legacy ref docs/engineering/BOM.md 1.8. Preliminary unit estimate EUR 20.00–40.00. Not a supplier quote. SONIC_HEAD.md mass budget mentions 8x M12x40. The flange is 6x M10. The kit is not exploded. | VC-SH-1800 | 0 | A | draft |  | 0
