GROUNDUP-GmbH/vibrocore/cad/odoo/plm/product.supplierinfo.csv

id | product_id/id | partner_id/id | min_qty | price | currency_id/id | product_code
vibrocore.seller_vc_ct_6100 | vibrocore.product_vc_ct_6100 | vibrocore.partner_wago | 1.0 | 600.00 | base.EUR | 750-8212
vibrocore.seller_vc_ct_6110 | vibrocore.product_vc_ct_6110 | vibrocore.partner_wago | 1.0 | 60.00 | base.EUR | 750-430
vibrocore.seller_vc_ct_6120 | vibrocore.product_vc_ct_6120 | vibrocore.partner_wago | 1.0 | 60.00 | base.EUR | 750-530
vibrocore.seller_vc_ct_6130 | vibrocore.product_vc_ct_6130 | vibrocore.partner_wago | 1.0 | 100.00 | base.EUR | 750-637
vibrocore.seller_vc_ct_6140 | vibrocore.product_vc_ct_6140 | vibrocore.partner_wago | 1.0 | 80.00 | base.EUR | 750-826
vibrocore.seller_vc_ct_6150 | vibrocore.product_vc_ct_6150 | vibrocore.partner_wago | 1.0 | 10.00 | base.EUR | 750-600
vibrocore.seller_vc_ct_6500 | vibrocore.product_vc_ct_6500 | vibrocore.partner_ublox | 1.0 | 50.00 | base.EUR | ANN-MB
vibrocore.seller_vc_ct_6510 | vibrocore.product_vc_ct_6510 | vibrocore.partner_ublox | 1.0 | 150.00 | base.EUR | ZED-F9P
vibrocore.seller_vc_ct_6600 | vibrocore.product_vc_ct_6600 | vibrocore.partner_teltonika | 1.0 | 100.00 | base.EUR | RUT241
vibrocore.seller_vc_fr_4100 | vibrocore.product_vc_fr_4100 | vibrocore.partner_mk | 1.0 | 60.00 | base.EUR
vibrocore.seller_vc_fr_4200 | vibrocore.product_vc_fr_4200 | vibrocore.partner_mk | 1.0 | 5.00 | base.EUR
vibrocore.seller_vc_fr_4300 | vibrocore.product_vc_fr_4300 | vibrocore.partner_custom_eu | 1.0 | 80.00 | base.EUR
vibrocore.seller_vc_fr_4400 | vibrocore.product_vc_fr_4400 | vibrocore.partner_custom_eu | 1.0 | 50.00 | base.EUR
vibrocore.seller_vc_fr_4500 | vibrocore.product_vc_fr_4500 | vibrocore.partner_custom_eu | 1.0 | 20.00 | base.EUR
vibrocore.seller_vc_fr_4600 | vibrocore.product_vc_fr_4600 | vibrocore.partner_custom_eu | 1.0 | 15.00 | base.EUR
vibrocore.seller_vc_gp_7100 | vibrocore.product_vc_gp_7100 | vibrocore.partner_geoprobe | 1.0 | 400.00 | base.EUR | 201446
vibrocore.seller_vc_gp_7200 | vibrocore.product_vc_gp_7200 | vibrocore.partner_geoprobe | 1.0 | 50.00 | base.EUR | 205449
vibrocore.seller_vc_gp_7300 | vibrocore.product_vc_gp_7300 | vibrocore.partner_geoprobe | 1.0 | 100.00 | base.EUR | 201275
vibrocore.seller_vc_gp_7400 | vibrocore.product_vc_gp_7400 | vibrocore.partner_geoprobe | 1.0 | 3.00 | base.EUR
vibrocore.seller_vc_hb_2200 | vibrocore.product_vc_hb_2200 | vibrocore.partner_neugart | 1.0 | 600.00 | base.EUR | PLPE120-040
vibrocore.seller_vc_hb_2500 | vibrocore.product_vc_hb_2500 | vibrocore.partner_custom_eu | 1.0 | 30.00 | base.EUR
vibrocore.seller_vc_hb_3200 | vibrocore.product_vc_hb_3200 | vibrocore.partner_custom_eu | 1.0 | 80.00 | base.EUR
vibrocore.seller_vc_ps_8100 | vibrocore.product_vc_ps_8100 | vibrocore.partner_pix4d | 1.0 | 2000.00 | base.EUR
vibrocore.seller_vc_pw_5100 | vibrocore.product_vc_pw_5100 | vibrocore.partner_instagrid | 1.0 | 2500.00 | base.EUR
vibrocore.seller_vc_pw_5600 | vibrocore.product_vc_pw_5600 | vibrocore.partner_lapp | 1.0 | 40.00 | base.EUR
vibrocore.seller_vc_sh_1100 | vibrocore.product_vc_sh_1100 | vibrocore.partner_oli | 1.0 | 300.00 | base.EUR | MVE 400/6-HF
vibrocore.seller_vc_sh_1300 | vibrocore.product_vc_sh_1300 | vibrocore.partner_custom_eu | 1.0 | 200.00 | base.EUR
vibrocore.seller_vc_sh_1400 | vibrocore.product_vc_sh_1400 | vibrocore.partner_custom_eu | 1.0 | 80.00 | base.EUR
vibrocore.seller_vc_sh_1500 | vibrocore.product_vc_sh_1500 | vibrocore.partner_custom_eu | 1.0 | 60.00 | base.EUR
vibrocore.seller_vc_sh_1700 | vibrocore.product_vc_sh_1700 | vibrocore.partner_lapp | 1.0 | 7.50 | base.EUR
