GROUNDUP-GmbH/vibrocore/cad/export/step/VC-FR-4100.step

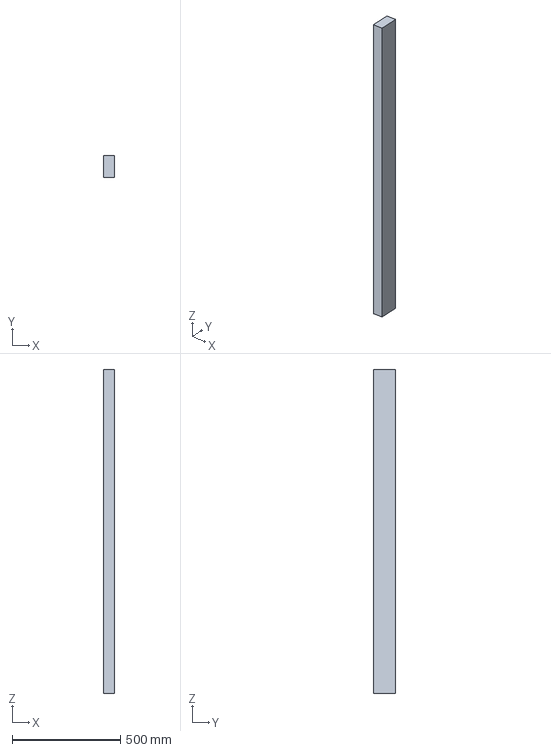
[picture p1: CAD file, 2026-11-04]
cad/export/step/VC-FR-4100.step
50.0 x 100.0 x 1500.0 mm
