GROUNDUP-GmbH/vibrocore/cad/export/pdf/VC-ASM-2000_hub-system-assembly.pdf

VC-ASM-2000 Hub system assembly assembly, preliminary 1 VC-HB-2100 rev A qty 1 NEMA 42 closed-loop stepper 2 VC-HB-2200 rev A qty 1 Planetary gearbox PLPE120-040 3 VC-HB-2300 rev A qty 1 Closed-loop stepper driver
4 VC-HB-2400 rev A qty 1 Elastomer coupling
5 VC-HB-2500 rev A qty 1 Hub drive shaft
6 VC-HB-2600 rev A qty 2 Pillow block UCP 206
7 VC-HB-2700 rev A qty 1 Duplex chain 10B-2
8 VC-HB-2800 rev A qty 1 Sprocket 10B-2 15T drive 9 VC-HB-2810 rev A qty 1 Sprocket 10B-2 15T idle 10 VC-HB-2900 rev A qty 1 Chain tensioner
11 VC-HB-3000 rev A qty 1 Power-off brake 24 V 12 VC-HB-3100 rev A qty 2 Linear guide rail HGR20 13 VC-HB-3110 rev A qty 4 Linear carriage HGH20 14 VC-HB-3200 rev A qty 1 Carriage plate
15 VC-HB-3300 rev A qty 1 Fastener kit, hub Owner: Ground UP GmbH
Document status: preliminary
Identification: VC-ASM-2000
Revision index/letter: 0 / A
Date: 2026-11-04
Units: mm. Projection: first angle (ISO 128).
General tolerances: TODO.
ISO 7200 title-block fields. Not released for manufacture.
