GROUNDUP-GmbH/vibrocore/cad/export/pdf/VC-ASM-3000_frame-assembly.pdf

VC-ASM-3000 Frame assembly assembly, preliminary
1 VC-FR-4100 rev A qty 2 Aluminium profile 50x100x1500 2 VC-FR-4200 rev A qty 8 Profile connector
3 VC-FR-4300 rev A qty 1 Bottom steel plate
4 VC-FR-4400 rev A qty 1 Top steel plate
5 VC-FR-4500 rev A qty 1 Rod guide bushing
6 VC-FR-4600 rev A qty 4 UTV mounting bracket 7 VC-FR-4700 rev A qty 1 Tilt mechanism
8 VC-FR-4800 rev A qty 4 Stabiliser foot
9 VC-FR-4900 rev A qty 1 Fastener kit, frame Owner: Ground UP GmbH
Document status: preliminary
Identification: VC-ASM-3000
Revision index/letter: 0 / A
Date: 2026-11-04
Units: mm. Projection: first angle (ISO 128).
General tolerances: TODO.
ISO 7200 title-block fields. Not released for manufacture.
