GROUNDUP-GmbH/vibrocore/(commit log)

2026-03-15 feat: Initial project setup — sonic head design, hub system, BOM, firmware
    Complete project scaffold for the Vibrocore open-source compact electric
    sonic soil sampler (DT325-compatible). Includes:
    - README with system architecture and key specifications
    - Sonic head design: dual counter-rotating eccentrics, timing belt sync,
    force/frequency calculations (8 kN @ 100 Hz)
    - Hub system design: NEMA 42 + Neugart PLPE120 (40:1) + 10B-2 chain
    - Engineering dimensioning: forces, bearing life, power, energy per cycle
    - Preliminary BOM with EU suppliers (~8,650 € V1 prototype)
    - Reference literature compilation (Šporin 2017, Wang 2015, etc.)
    - Arduino hub control firmware with stone detection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
2026-03-15 feat: Redesign sonic head to 2× OLI MVE 400/6-HF counter-rotating pair
    Major design pivot from custom eccentric mechanism to off-the-shelf OLI
    industrial vibration motors. Key improvements:
    - 2× OLI MVE 400/6-HF (4 kN each, 8 kN combined axial force)
    - Self-synchronising via shared vibrating plate (no timing belts)
    - 60% less power draw (1.2 kW vs 3.0 kW)
    - 48% less energy per sampling cycle (0.029 vs 0.056 kWh)
    - ~72 cores per Instagrid charge (vs 37)
    - ~1,000 € cheaper (head subtotal 1,185–1,900 vs 1,930–3,110)
    - 1–2 weeks assembly vs 4–8 weeks custom fabrication
    - Eliminates: custom shafts, discs, belt, 4 external bearings, housing
    Updated: SONIC_HEAD.md, DIMENSIONING.md, BO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
2026-03-31 [WS6][FIRMWARE] feat: Add WAGO PFC200 XTR CODESYS control system
    Replaces Arduino/CONTROLLINO prototype with production-ready WAGO
    PFC200 XTR (IEC 61131-3 Structured Text) as the V1 control system.
    CODESYS files (firmware/codesys/):
    - GVL_IO.st: Physical I/O mapping for 750-430/530/637/826 modules
    - GVL_PARAMS.st: Machine constants (kinematics, Modbus registers, safety thresholds)
    - FB_Safety.st: Safety monitor (E-Stop, limits, stone detection via overcurrent)
    - FB_ModbusVFD.st: Siemens V20 Modbus RTU with OFF3 fast-stop (200-400ms)
    - FB_SonicHead.st: OLI MVE 400/6-HF state machine with adaptive freq control
    - FB_HubControl.st: Hub state machine with sonic-stop interlock
    - PRG_Main.st: Main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
    [FB_DataLogger.st, FB_HubControl.st, FB_ModbusVFD.st, FB_Safety.st, FB_SonicHead.st, GVL_IO.st, GVL_PARAMS.st, PRG_Main.st]
2026-03-31 [WS6][FIRMWARE] test: Add Python state machine test suite (59 tests, all passing)
    Adds a complete hardware-free test suite that formally verifies the
    CODESYS state machine logic, especially the critical sonic-hub interlock.
    tests/sim.py — IEC 61131-3 simulator:
    - TON, R_TRIG timer simulation (exact IEC 61131-3 behaviour)
    - MockVFD: Siemens V20 with OFF3 fast-stop and OFF1 normal-stop timing
    - FB_Safety, FB_SonicHead, FB_HubControl as faithful Python translations
    - Vibrocore class (PRG_Main equivalent) wiring all FBs together
    Test coverage (59 tests):
    - test_safety.py: E-Stop priority, NC limit switch logic, stone debounce
    - test_sonic.py: startup ramp, resonance band skip, fa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
2026-03-31 [WS6][FIRMWARE] docs: Add Teltonika RUT241 and braking energy analysis
    Teltonika RUT241 (LTE Cat4, DIN-rail, -40..+75°C):
    Added to BOM section 5 and CONTROL_SYSTEM.md as the LTE uplink for
    remote CODESYS debugging, OTA updates, and MQTT to RDDL/cloud.
    Replaces generic GL.iNet reference with the industrially rated
    Teltonika unit consistent with the GTD hardware ecosystem.
    Power: 24V → step-down → 9V, ~3W draw.
    Braking energy analysis (CONTROL_SYSTEM.md new section):
    Formally resolves whether an external braking resistor is required
    for the 80 J fast-stop energy of the 2× OLI MVE 400/6-HF motors.
    Result: no external resistor needed.
    - 80 J via DC injection braking (P12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
2026-11-04 feat: add CAD BOM, drawings and OdooPLM sync (#1)
    Single-source BOM, STEP/PDF/SVG exports and a draft-only OdooPLM sync.
    - 72 parts and 9 BOMs in cad/bom/vibrocore.bom.yaml
    - build123d STEP, PDF/SVG drawings and Odoo CSV imports
    - plm-sync writes draft products, documents, links and ebom only; dry-run is default
    - remove tracked pycache and report an unreachable Odoo as a clean error
